Spirik/no_DICE/assets/images/features.png

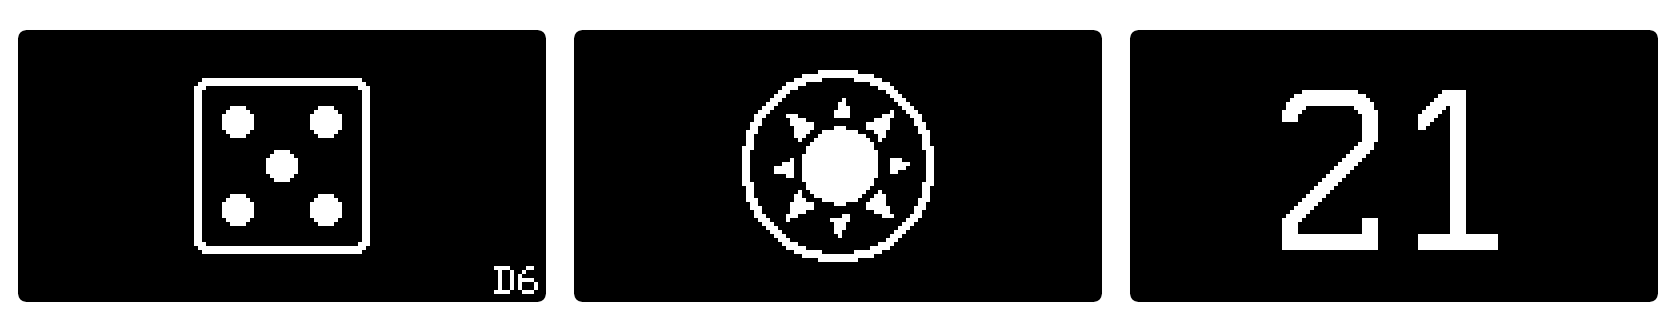
assets/images/features.png
