Spirik/no_DICE/hardware/enclosure/frame/nodice-frame-v18_decor-v1.stl

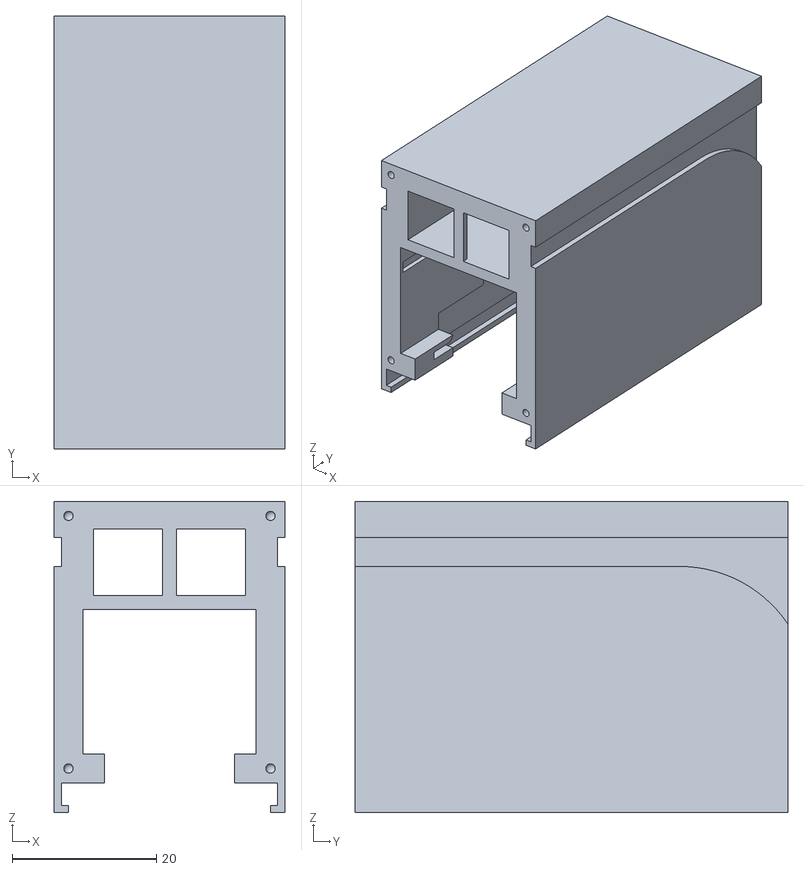
[picture p38: CAD file, 2026-11-01]
hardware/enclosure/frame/nodice-frame-v18_decor-v1.stl
32.0 x 60.0 x 43.1
