Spirik/no_DICE/hardware/enclosure/no_DICE-Enclosure-v18.step

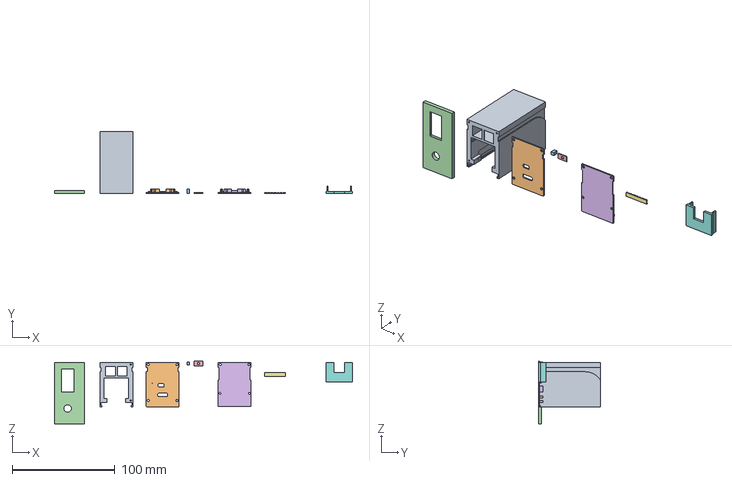
[picture p39: CAD file, 2026-11-01]
hardware/enclosure/no_DICE-Enclosure-v18.step
289.8 x 60.0 x 61.1 mm
