Spirik/no_DICE/hardware/enclosure/side-cover/nodice-side-v09_decor-v1.stl

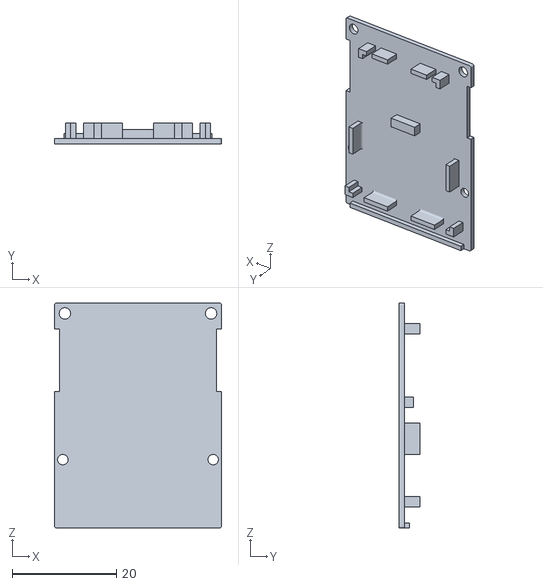
[picture p40: CAD file, 2026-11-01]
hardware/enclosure/side-cover/nodice-side-v09_decor-v1.stl
32.0 x 4.00 x 43.1
