Spirik/no_DICE/hardware/enclosure/side-io-cover/nodice-side-io-v14_decor-v1.stl

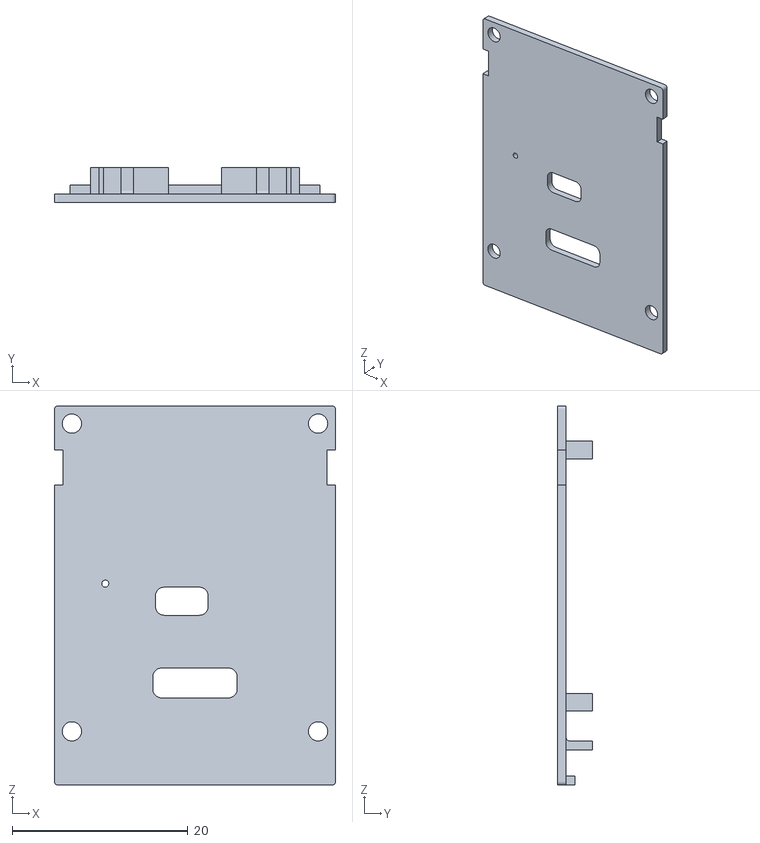
[picture p41: CAD file, 2026-11-01]
hardware/enclosure/side-io-cover/nodice-side-io-v14_decor-v1.stl
32.0 x 4.00 x 43.1
