Spirik/no_DICE/hardware/enclosure/spacer/nodice-spacer-v01.stl

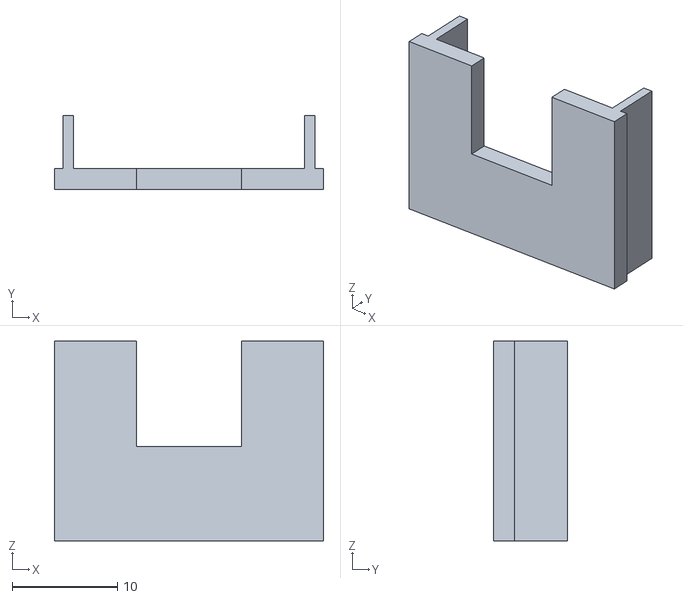
[picture p42: CAD file, 2026-11-01]
hardware/enclosure/spacer/nodice-spacer-v01.stl
25.6 x 7.00 x 19.0
