Spirik/no_DICE/hardware/enclosure/switch-skirt/nodice-switch-skirt-v02.stl

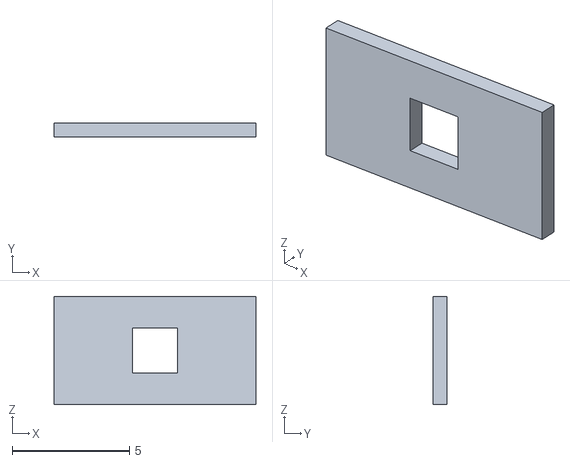
[picture p43: CAD file, 2026-11-01]
hardware/enclosure/switch-skirt/nodice-switch-skirt-v02.stl
8.60 x 0.6 x 4.60
