Spirik/no_DICE/hardware/enclosure/top-cover/nodice-top-v07.stl

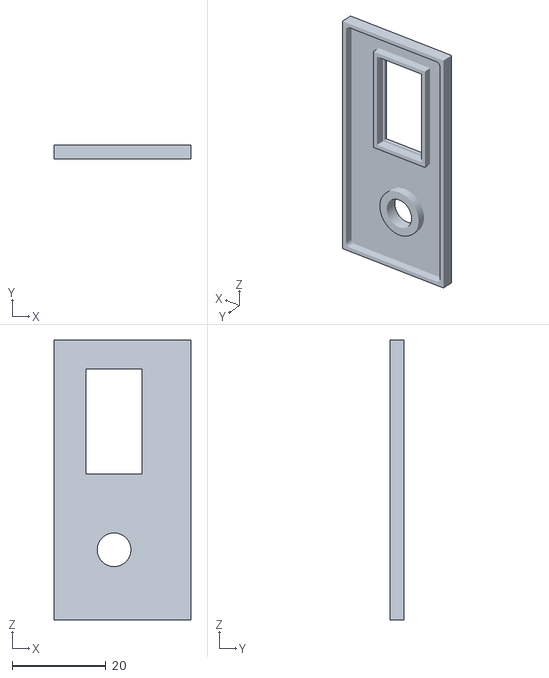
[picture p44: CAD file, 2026-11-01]
hardware/enclosure/top-cover/nodice-top-v07.stl
29.2 x 3.00 x 59.8
