Spirik/no_DICE/(list of files, cad)

Other CAD files:
hardware/enclosure/no_DICE-Enclosure-v18.f3d
