Spirik/no_DICE/hardware/enclosure/no_DICE-Case-Drawing-v18.pdf

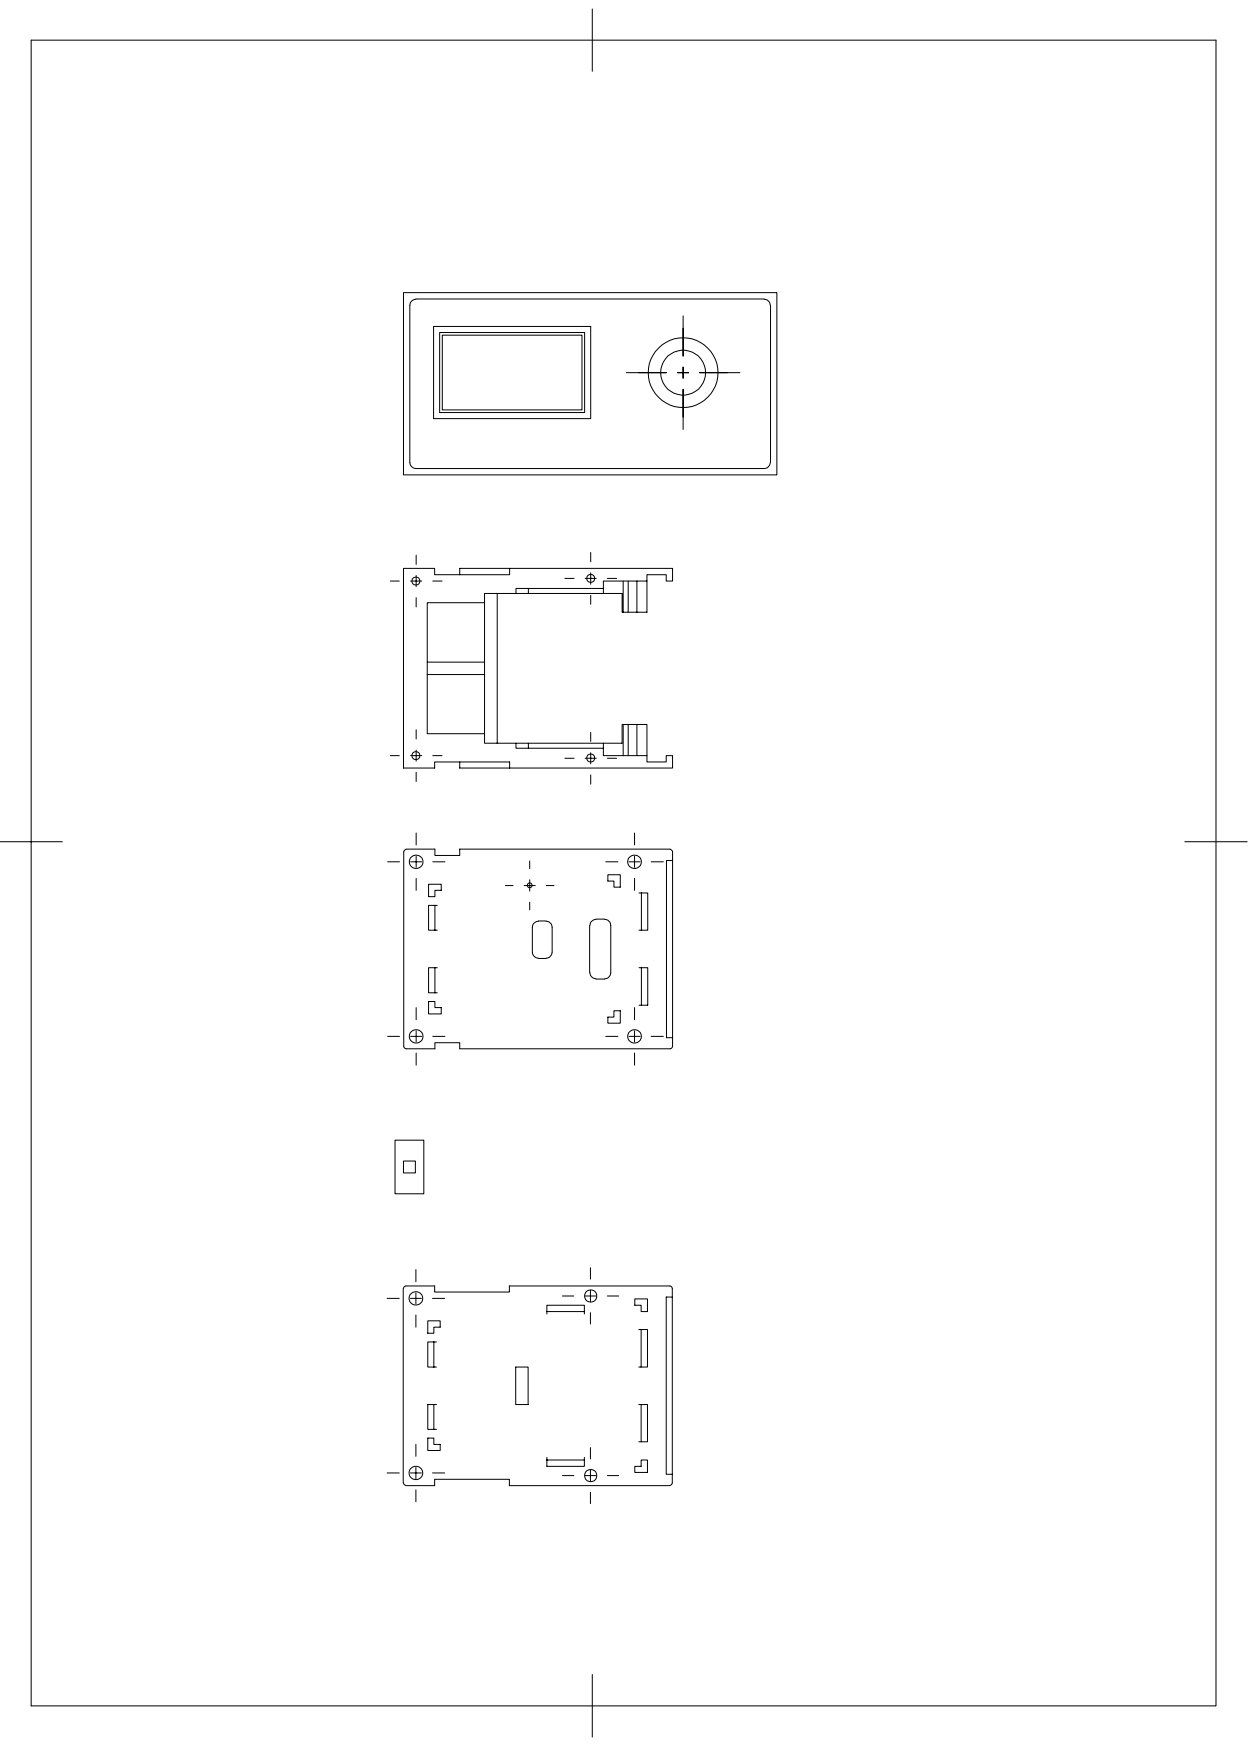
[picture p45: page 1]
