Spirik/no_DICE/src/no_DICE_gem-u8g2/sprites-coin.h

/*
  Sprites of the animation frames used for flipping a coin in no_DICE.

  For documentation visit:
  https://github.com/Spirik/no_DICE

  Copyright (c) 2026 Alexander 'Spirik' Spiridonov

  This file is part of no_DICE program.

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
  You should have received a copy of the GNU Lesser General Public License
  along with this program.  If not, see <http://www.gnu.org/licenses/>.
*/

//====================== Horizontal flip (Intro animation)

#define coinIntroFrame0_width  48
#define coinIntroFrame0_height 48
static const uint8_t coinIntroFrame0_bits [] PROGMEM = {
  0x00, 0x00, 0xE0, 0x07, 0x00, 0x00, 0x00, 0x00, 0xF0, 0x0F, 0x00, 0x00, 
  0x00, 0x00, 0x38, 0x1C, 0x00, 0x00, 0x00, 0x00, 0x18, 0x18, 0x00, 0x00, 
  0x00, 0x00, 0x98, 0x19, 0x00, 0x00, 0x00, 0x00, 0x18, 0x18, 0x00, 0x00, 
  0x00, 0x00, 0xD8, 0x1B, 0x00, 0x00, 0x00, 0x00, 0x18, 0x18, 0x00, 0x00, 
  0x00, 0x00, 0x18, 0x18, 0x00, 0x00, 0x00, 0x00, 0xD8, 0x1B, 0x00, 0x00, 
  0x00, 0x00, 0x18, 0x18, 0x00, 0x00, 0x00, 0x00, 0x18, 0x18, 0x00, 0x00, 
  0x00, 0x00, 0x18, 0x18, 0x00, 0x00, 0x00, 0x00, 0xD8, 0x1B, 0x00, 0x00, 
  0x00, 0x00, 0x18, 0x18, 0x00, 0x00, 0x00, 0x00, 0x18, 0x18, 0x00, 0x00, 
  0x00, 0x00, 0x18, 0x18, 0x00, 0x00, 0x00, 0x00, 0x18, 0x18, 0x00, 0x00, 
  0x00, 0x00, 0xD8, 0x1B, 0x00, 0x00, 0x00, 0x00, 0x18, 0x18, 0x00, 0x00, 
  0x00, 0x00, 0x18, 0x18, 0x00, 0x00, 0x00, 0x00, 0x18, 0x18, 0x00, 0x00, 
  0x00, 0x00, 0x18, 0x18, 0x00, 0x00, 0x00, 0x00, 0x18, 0x18, 0x00, 0x00, 
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
  0x00, 0xC0, 0x01, 0xE0, 0x03, 0x00, 0x00, 0x80, 0x03, 0xF0, 0x01, 0x00, 
  0x00, 0x00, 0x07, 0xF8, 0x00, 0x00, 0x00, 0x00, 0x1E, 0x7E, 0x00, 0x00, 
  0x00, 0x00, 0xFC, 0x3F, 0x00, 0x00, 0x00, 0x00, 0xE0, 0x0F, 0x00, 0x00
};

const GEMSprite coinIntroFrame0 = {coinIntroFrame0_width, coinIntroFrame0_height, coinIntroFrame0_bits};
const GEMSprite coinIntroFrame1 = {coinIntroFrame1_width, coinIntroFrame1_height, coinIntroFrame1_bits};
const GEMSprite coinIntroFrame2 = {coinIntroFrame2_width, coinIntroFrame2_height, coinIntroFrame2_bits};
const GEMSprite coinIntroFrame3 = {coinIntroFrame3_width, coinIntroFrame3_height, coinIntroFrame3_bits};
const GEMSprite coinIntroFrame4 = {coinIntroFrame4_width, coinIntroFrame4_height, coinIntroFrame4_bits};
const GEMSprite coinIntroFrame5 = {coinIntroFrame5_width, coinIntroFrame5_height, coinIntroFrame5_bits};
const GEMSprite coinIntroFrame6 = coinIntroFrame0;
const GEMSprite coinIntroFrame7 = {coinIntroFrame7_width, coinIntroFrame7_height, coinIntroFrame7_bits};
const GEMSprite coinIntroFrame8 = {coinIntroFrame8_width, coinIntroFrame8_height, coinIntroFrame8_bits};
const GEMSprite coinIntroFrame9 = {coinIntroFrame9_width, coinIntroFrame9_height, coinIntroFrame9_bits};
const GEMSprite coinIntroFrame10 = {coinIntroFrame10_width, coinIntroFrame10_height, coinIntroFrame10_bits};
const GEMSprite coinIntroFrame11 = {coinIntroFrame11_width, coinIntroFrame11_height, coinIntroFrame11_bits};

const GEMSprite coinIntroFrames[] = {
  coinIntroFrame0,
  coinIntroFrame1,
  coinIntroFrame2,
  coinIntroFrame3,
  coinIntroFrame4,
  coinIntroFrame5,
  coinIntroFrame6,
  coinIntroFrame7,
  coinIntroFrame8,
  coinIntroFrame9,
  coinIntroFrame10,
  coinIntroFrame11,
};

//====================== Vertical flip (Toss animation)

#define coinVerticalFrame0_width  48
#define coinVerticalFrame0_height 48
static const uint8_t coinVerticalFrame0_bits [] PROGMEM = {
  0x00, 0x00, 0x00, 0x00, 0x00, 0x00, 0x00, 0x00, 0x00, 0x00, 0x00, 0x00, 
  0x00, 0x00, 0x00, 0x00, 0x00, 0x00, 0x00, 0x00, 0x00, 0x00, 0x00, 0x00, 
  0x00, 0x00, 0x00, 0x00, 0x00, 0x00, 0x00, 0x00, 0x00, 0x00, 0x00, 0x00, 
  0x00, 0x00, 0x00, 0x00, 0x00, 0x00, 0x00, 0x00, 0x00, 0x00, 0x00, 0x00, 
  0x00, 0x00, 0x00, 0x00, 0x00, 0x00, 0x00, 0x00, 0x00, 0x00, 0x00, 0x00, 
  0x00, 0x00, 0x00, 0x00, 0x00, 0x00, 0x00, 0x00, 0x00, 0x00, 0x00, 0x00, 
  0x00, 0x00, 0x00, 0x00, 0x00, 0x00, 0x00, 0x00, 0x00, 0x00, 0x00, 0x00, 
  0x00, 0x00, 0x00, 0x00, 0x00, 0x00, 0x00, 0x00, 0x00, 0x00, 0x00, 0x00, 
  0x00, 0x00, 0x00, 0x00, 0x00, 0x00, 0x00, 0x00, 0x00, 0x00, 0x00, 0x00, 
  0x00, 0x00, 0x00, 0x00, 0x00, 0x00, 0xFC, 0xFF, 0xFF, 0xFF, 0xFF, 0x3F, 
  0xFE, 0xFF, 0xFF, 0xFF, 0xFF, 0x7F, 0x07, 0x00, 0x00, 0x00, 0x00, 0xE0, 
  0x43, 0x22, 0x84, 0x20, 0x44, 0xC2, 0x53, 0x22, 0x84, 0x20, 0x44, 0xCA, 
  0x53, 0x22, 0x84, 0x20, 0x44, 0xCA, 0x43, 0x22, 0x84, 0x20, 0x44, 0xC2, 
  0x07, 0x00, 0x00, 0x00, 0x00, 0xE0, 0xFE, 0xFF, 0xFF, 0xFF, 0xFF, 0x7F, 
  0xFC, 0xFF, 0xFF, 0xFF, 0xFF, 0x3F, 0x00, 0x00, 0x00, 0x00, 0x00, 0x00, 
  0x00, 0x00, 0x00, 0x00, 0x00, 0x00, 0x00, 0x00, 0x00, 0x00, 0x00, 0x00, 
  0x00, 0x00, 0x00, 0x00, 0x00, 0x00, 0x00, 0x00, 0x00, 0x00, 0x00, 0x00, 
  0x00, 0x00, 0x00, 0x00, 0x00, 0x00, 0x00, 0x00, 0x00, 0x00, 0x00, 0x00, 
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
  0x00, 0x00, 0x00, 0x00, 0x00, 0x00, 0x00, 0x00, 0x00, 0x00, 0x00, 0x00, 
  0x00, 0x00, 0x00, 0x00, 0x00, 0x00, 0x00, 0x00, 0x00, 0x00, 0x00, 0x00, 
  0x00, 0x00, 0x00, 0x00, 0x00, 0x00, 0x00, 0x00, 0x00, 0x00, 0x00, 0x00
};

const GEMSprite coinVerticalFrame0 = {coinVerticalFrame0_width, coinVerticalFrame0_height, coinVerticalFrame0_bits};
const GEMSprite coinVerticalFrame1 = {coinVerticalFrame1_width, coinVerticalFrame1_height, coinVerticalFrame1_bits};
const GEMSprite coinVerticalFrame2 = {coinVerticalFrame2_width, coinVerticalFrame2_height, coinVerticalFrame2_bits};
const GEMSprite coinVerticalFrame3 = {coinVerticalFrame3_width, coinVerticalFrame3_height, coinVerticalFrame3_bits};
const GEMSprite coinVerticalFrame4 = {coinVerticalFrame4_width, coinVerticalFrame4_height, coinVerticalFrame4_bits};
const GEMSprite coinVerticalFrame5 = {coinVerticalFrame5_width, coinVerticalFrame5_height, coinVerticalFrame5_bits};
const GEMSprite coinVerticalFrame6 = coinVerticalFrame0;
const GEMSprite coinVerticalFrame7 = {coinVerticalFrame7_width, coinVerticalFrame7_height, coinVerticalFrame7_bits};
const GEMSprite coinVerticalFrame8 = {coinVerticalFrame8_width, coinVerticalFrame8_height, coinVerticalFrame8_bits};
const GEMSprite coinVerticalFrame9 = {coinVerticalFrame9_width, coinVerticalFrame9_height, coinVerticalFrame9_bits};
const GEMSprite coinVerticalFrame10 = {coinVerticalFrame10_width, coinVerticalFrame10_height, coinVerticalFrame10_bits};
const GEMSprite coinVerticalFrame11 = {coinVerticalFrame11_width, coinVerticalFrame11_height, coinVerticalFrame11_bits};

const GEMSprite coinVerticalFrames[] = {
  coinVerticalFrame0,
  coinVerticalFrame1,
  coinVerticalFrame2,
  coinVerticalFrame3,
  coinVerticalFrame4,
  coinVerticalFrame5,
  coinVerticalFrame6,
  coinVerticalFrame7,
  coinVerticalFrame8,
  coinVerticalFrame9,
  coinVerticalFrame10,
  coinVerticalFrame11,
};
