Spirik/no_DICE/src/no_DICE_gem-u8g2/sprites-dice.h

/*
  Sprites used for throwing a dice in no_DICE.

  For documentation visit:
  https://github.com/Spirik/no_DICE

  Copyright (c) 2026 Alexander 'Spirik' Spiridonov

  This file is part of no_DICE program.

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
  You should have received a copy of the GNU Lesser General Public License
  along with this program.  If not, see <http://www.gnu.org/licenses/>.
*/

//====================== Dice shape variants

#define diceVariantD4_width  64
#define diceVariantD4_height 64
static const uint8_t diceVariantD4_bits [] PROGMEM = {
  0x00, 0x00, 0x00, 0x00, 0x00, 0x00, 0x00, 0x00, 0x00, 0x00, 0x00, 0x00, 
  0x00, 0x00, 0x00, 0x00, 0x00, 0x00, 0x00, 0x00, 0x00, 0x00, 0x00, 0x00, 
  0x00, 0x00, 0x00, 0x00, 0x00, 0x00, 0x00, 0x00, 0x00, 0x00, 0x00, 0x00, 
  0x00, 0x00, 0x00, 0x00, 0x00, 0x00, 0x00, 0x00, 0x00, 0x00, 0x00, 0x00, 
  0x00, 0x00, 0x00, 0x80, 0x01, 0x00, 0x00, 0x00, 0x00, 0x00, 0x00, 0xC0, 
  0x03, 0x00, 0x00, 0x00, 0x00, 0x00, 0x00, 0xC0, 0x03, 0x00, 0x00, 0x00, 
  0x00, 0x00, 0x00, 0xE0, 0x07, 0x00, 0x00, 0x00, 0x00, 0x00, 0x00, 0x60, 
  0x06, 0x00, 0x00, 0x00, 0x00, 0x00, 0x00, 0x30, 0x0C, 0x00, 0x00, 0x00, 
  0x00, 0x00, 0x00, 0x38, 0x1C, 0x00, 0x00, 0x00, 0x00, 0x00, 0x00, 0x18, 
  0x18, 0x00, 0x00, 0x00, 0x00, 0x00, 0x00, 0x1C, 0x38, 0x00, 0x00, 0x00, 
  0x00, 0x00, 0x00, 0x0C, 0x30, 0x00, 0x00, 0x00, 0x00, 0x00, 0x00, 0x06, 
  0x60, 0x00, 0x00, 0x00, 0x00, 0x00, 0x00, 0x07, 0xE0, 0x00, 0x00, 0x00, 
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
const GEMSprite diceD6Result6 = {diceD6Result6_width, diceD6Result6_height, diceD6Result6_bits};

const GEMSprite diceD6Results[] = {
  diceD6Result1,
  diceD6Result2,
  diceD6Result3,
  diceD6Result4,
  diceD6Result5,
  diceD6Result6,
};
