Spirik/no_DICE/(commit log)

2026-11-02 Additional battery charging note
2026-11-02 Fix extra call to `saveSettings()` on sketch start
    [no_DICE_gem-u8g2.ino]
